INO-quantum/scanning-cavity-lock/SCTL_Arduino/ramp.cpp

// created by waveform.py triangle 2026-03-02 15:59:13

#include "ramp.h"

uint16_t ramp_buffer[8192] = {
    4096, //    0
    4097, //    1
    4098, //    2
    4099, //    3
    4100, //    4
    4101, //    5
    4102, //    6
    4103, //    7
    4104, //    8
    4105, //    9
    4106, //   10
    4107, //   11
    4108, //   12
    4109, //   13
    4110, //   14
    4111, //   15
    4112, //   16
    4113, //   17
    4114, //   18
    4115, //   19
    4116, //   20
    4117, //   21
    4118, //   22
    4119, //   23
    4120, //   24
    4121, //   25
    4122, //   26
    4123, //   27
    4124, //   28
    4125, //   29
    4126, //   30
    4127, //   31
    4128, //   32
    4129, //   33
    4130, //   34
    4131, //   35
    4132, //   36
    4133, //   37
    4134, //   38
    4135, //   39
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
};
